JustBrenkman/sora/projects/pinion/hardware/pinion-main/README.md

# pinion-main

Main board: TI AM62L and STM32H743 flight controller on one PCB.

Create the KiCad project here as `pinion-main.kicad_pro`.

[SCHEMATIC_TODO.md](SCHEMATIC_TODO.md) lists every part to place and the nets it
connects to. Net labels come from the pin maps in `../../specs/pinout/`.
