JustBrenkman/sora/projects/pinion/specs/notes/am62l-io-domains.md

<!-- SPDX-License-Identifier: CC-BY-4.0 -->
# AM62L I/O supply groups

Generated by `specs/tools/gen_am62l_pindef.py` from Table 5-1 of the AM62L
datasheet. pinmap has no field for a ball's I/O supply, so it is kept here.
A pin's I/O voltage is the voltage of the supply rail listed for its group.

## VDDA_1P8_DSI (1.8V)

| Ball | Pin | PADCONFIG |
|---|---|---|
| A15 | DSI0_TXCLKN |  |
| A14 | DSI0_TXCLKP |  |
| B19 | DSI0_TXN0 |  |
| A18 | DSI0_TXN1 |  |
| A20 | DSI0_TXN2 |  |
| B22 | DSI0_TXN3 |  |
| B18 | DSI0_TXP0 |  |
| A17 | DSI0_TXP1 |  |
| A21 | DSI0_TXP2 |  |
| B21 | DSI0_TXP3 |  |
| D17 | DSI0_TXRCALIB |  |

## VDDA_ADC (1.8V)

| Ball | Pin | PADCONFIG |
|---|---|---|
| V20 | ADC0_AIN0 |  |
| V22 | ADC0_AIN1 |  |
| V23 | ADC0_AIN2 |  |
| V21 | ADC0_AIN3 |  |

## VDDS0 (1.8V)

| Ball | Pin | PADCONFIG |
|---|---|---|
| Y16 | EMU0 | 0x04084034 |
| AA16 | EMU1 | 0x04084038 |
| AC15 | MDIO0_MDC | 0x0408414C |
| AC13 | MDIO0_MDIO | 0x04084148 |
| Y8 | RGMII1_RD0 | 0x04084138 |
| AA6 | RGMII1_RD1 | 0x0408413C |
| AA8 | RGMII1_RD2 | 0x04084140 |
| W8 | RGMII1_RD3 | 0x04084144 |
| Y7 | RGMII1_RXC | 0x04084134 |
| Y6 | RGMII1_RX_CTL | 0x04084130 |
| AC10 | RGMII1_TD0 | 0x04084120 |
| W13 | RGMII1_TD1 | 0x04084124 |
| Y11 | RGMII1_TD2 | 0x04084128 |
| AA11 | RGMII1_TD3 | 0x0408412C |
| W11 | RGMII1_TXC | 0x0408411C |
| AB11 | RGMII1_TX_CTL | 0x04084118 |
| AB9 | RGMII2_RD0 | 0x04084170 |
| AC9 | RGMII2_RD1 | 0x04084174 |
| AB10 | RGMII2_RD2 | 0x04084178 |
| AB8 | RGMII2_RD3 | 0x0408417C |
| AC7 | RGMII2_RXC | 0x0408416C |
| AC8 | RGMII2_RX_CTL | 0x04084168 |
| AC12 | RGMII2_TD0 | 0x04084158 |
| AB13 | RGMII2_TD1 | 0x0408415C |
| AA12 | RGMII2_TD2 | 0x04084160 |
| AA13 | RGMII2_TD3 | 0x04084164 |
| Y13 | RGMII2_TXC | 0x04084154 |
| AB12 | RGMII2_TX_CTL | 0x04084150 |
| AB14 | TCK | 0x04084020 |
| AC16 | TDI | 0x04084028 |
| AB15 | TDO | 0x0408402C |
| Y17 | TMS | 0x04084030 |
| AB16 | TRSTn | 0x04084024 |

## VDDS1 (1.8V)

| Ball | Pin | PADCONFIG |
|---|---|---|
| D22 | OSPI0_CLK | 0x0408403C |
| C20 | OSPI0_CSn0 | 0x04084068 |
| D20 | OSPI0_CSn1 | 0x0408406C |
| D18 | OSPI0_CSn2 | 0x04084070 |
| C23 | OSPI0_CSn3 | 0x04084074 |
| C22 | OSPI0_D0 | 0x04084048 |
| D21 | OSPI0_D1 | 0x0408404C |
| E23 | OSPI0_D2 | 0x04084050 |
| D23 | OSPI0_D3 | 0x04084054 |
| F21 | OSPI0_D4 | 0x04084058 |
| F19 | OSPI0_D5 | 0x0408405C |
| G20 | OSPI0_D6 | 0x04084060 |
| F20 | OSPI0_D7 | 0x04084064 |
| E22 | OSPI0_DQS | 0x04084044 |
| E18 | OSPI0_LBCLKO | 0x04084040 |

## VDDSHV0 (1.8V / 3.3V)

| Ball | Pin | PADCONFIG |
|---|---|---|
| L22 | GPMC0_AD0 | 0x04084078 |
| L23 | GPMC0_AD1 | 0x0408407C |
| H21 | GPMC0_AD10 | 0x040840A0 |
| H18 | GPMC0_AD11 | 0x040840A4 |
| G23 | GPMC0_AD12 | 0x040840A8 |
| G22 | GPMC0_AD13 | 0x040840AC |
| F22 | GPMC0_AD14 | 0x040840B0 |
| F23 | GPMC0_AD15 | 0x040840B4 |
| K22 | GPMC0_AD2 | 0x04084080 |
| J23 | GPMC0_AD3 | 0x04084084 |
| K23 | GPMC0_AD4 | 0x04084088 |
| H22 | GPMC0_AD5 | 0x0408408C |
| H23 | GPMC0_AD6 | 0x04084090 |
| J22 | GPMC0_AD7 | 0x04084094 |
| H19 | GPMC0_AD8 | 0x04084098 |
| H20 | GPMC0_AD9 | 0x0408409C |
| N19 | GPMC0_ADVn_ALE | 0x040840C0 |
| P23 | GPMC0_BE0n_CLE | 0x040840CC |
| P22 | GPMC0_BE1n | 0x040840D0 |
| L21 | GPMC0_CLK | 0x040840B8 |
| L20 | GPMC0_CSn0 | 0x040840E4 |
| L19 | GPMC0_CSn1 | 0x040840E8 |
| M23 | GPMC0_CSn2 | 0x040840EC |
| M22 | GPMC0_CSn3 | 0x040840F0 |
| M21 | GPMC0_DIR | 0x040840E0 |
| N20 | GPMC0_OEn_REn | 0x040840C4 |
| N23 | GPMC0_WAIT0 | 0x040840D4 |
| N22 | GPMC0_WAIT1 | 0x040840D8 |
| M19 | GPMC0_WEn | 0x040840C8 |
| N21 | GPMC0_WPn | 0x040840DC |

## VDDSHV1 (1.8V / 3.3V)

| Ball | Pin | PADCONFIG |
|---|---|---|
| C8 | EXTINTn | 0x040841E8 |
| D16 | EXT_REFCLK1 | 0x040841E4 |
| B7 | I2C0_SCL | 0x040841CC |
| A7 | I2C0_SDA | 0x040841D0 |
| D7 | I2C1_SCL | 0x040841D4 |
| A6 | I2C1_SDA | 0x040841D8 |
| B8 | I2C2_SCL | 0x040841DC |
| D8 | I2C2_SDA | 0x040841E0 |
| B15 | MCAN0_RX | 0x040841C8 |
| B16 | MCAN0_TX | 0x040841C4 |
| A12 | MCASP0_ACLKR | 0x0408419C |
| A11 | MCASP0_ACLKX | 0x04084190 |
| C11 | MCASP0_AFSR | 0x04084198 |
| B11 | MCASP0_AFSX | 0x04084194 |
| B9 | MCASP0_AXR0 | 0x0408418C |
| A9 | MCASP0_AXR1 | 0x04084188 |
| B10 | MCASP0_AXR2 | 0x04084184 |
| A8 | MCASP0_AXR3 | 0x04084180 |
| B6 | MMC1_SDCD | 0x04084234 |
| D6 | MMC1_SDWP | 0x04084238 |
| C16 | RESETSTATz | 0x04084240 |
| E16 | RESETz | 0x0408423C |
| E13 | SPI0_CLK | 0x040841A8 |
| E11 | SPI0_CS0 | 0x040841A0 |
| D11 | SPI0_CS1 | 0x040841A4 |
| E12 | SPI0_D0 | 0x040841AC |
| B12 | SPI0_D1 | 0x040841B0 |
| B14 | UART0_CTSn | 0x040841BC |
| B13 | UART0_RTSn | 0x040841C0 |
| D13 | UART0_RXD | 0x040841B4 |
| C13 | UART0_TXD | 0x040841B8 |
| C6 | USB0_DRVVBUS | 0x04084244 |
| A5 | USB1_DRVVBUS | 0x04084248 |

## VDDSHV2 (1.8V / 3.3V)

| Ball | Pin | PADCONFIG |
|---|---|---|
| B2 | MMC0_CLK | 0x0408420C |
| D2 | MMC0_CMD | 0x04084214 |
| D3 | MMC0_DAT0 | 0x04084208 |
| D4 | MMC0_DAT1 | 0x04084204 |
| C1 | MMC0_DAT2 | 0x04084200 |
| C2 | MMC0_DAT3 | 0x040841FC |
| C4 | MMC0_DAT4 | 0x040841F8 |
| B3 | MMC0_DAT5 | 0x040841F4 |
| A3 | MMC0_DAT6 | 0x040841F0 |
| B4 | MMC0_DAT7 | 0x040841EC |

## VDDSHV3 (1.8V / 3.3V)

| Ball | Pin | PADCONFIG |
|---|---|---|
| Y2 | MMC1_CLK | 0x04084228 |
| Y3 | MMC1_CMD | 0x04084230 |
| AA1 | MMC1_DAT0 | 0x04084224 |
| Y4 | MMC1_DAT1 | 0x04084220 |
| AA2 | MMC1_DAT2 | 0x0408421C |
| AB2 | MMC1_DAT3 | 0x04084218 |

## VDDSHV4 (1.8V / 3.3V)

| Ball | Pin | PADCONFIG |
|---|---|---|
| R23 | MMC2_CLK | 0x04084104 |
| U23 | MMC2_CMD | 0x0408410C |
| U22 | MMC2_DAT0 | 0x04084100 |
| T22 | MMC2_DAT1 | 0x040840FC |
| T23 | MMC2_DAT2 | 0x040840F8 |
| R22 | MMC2_DAT3 | 0x040840F4 |
| T20 | MMC2_SDCD | 0x04084110 |
| T21 | MMC2_SDWP | 0x04084114 |

## VDDS_DDR (1.1V / 1.2V)

| Ball | Pin | PADCONFIG |
|---|---|---|
| L5 | DDR0_A0 |  |
| H6 | DDR0_A1 |  |
| T5 | DDR0_A10 |  |
| T6 | DDR0_A11 |  |
| W6 | DDR0_A12 |  |
| V6 | DDR0_A13 |  |
| L6 | DDR0_A2 |  |
| K2 | DDR0_A3 |  |
| J1 | DDR0_A4 |  |
| H5 | DDR0_A5 |  |
| R2 | DDR0_A6 |  |
| N6 | DDR0_A7 |  |
| T4 | DDR0_A8 |  |
| N1 | DDR0_A9 |  |
| M2 | DDR0_ACT_n |  |
| N3 | DDR0_BA0 |  |
| N2 | DDR0_BA1 |  |
| N5 | DDR0_BG0 |  |
| N4 | DDR0_BG1 |  |
| M3 | DDR0_CAL0 |  |
| L1 | DDR0_CAS_n |  |
| P1 | DDR0_CK0 |  |
| P2 | DDR0_CK0_n |  |
| K1 | DDR0_CKE0 |  |
| L3 | DDR0_CS0_n |  |
| F2 | DDR0_DM0 |  |
| W2 | DDR0_DM1 |  |
| F4 | DDR0_DQ0 |  |
| F3 | DDR0_DQ1 |  |
| T1 | DDR0_DQ10 |  |
| U1 | DDR0_DQ11 |  |
| U4 | DDR0_DQ12 |  |
| V5 | DDR0_DQ13 |  |
| U2 | DDR0_DQ14 |  |
| W1 | DDR0_DQ15 |  |
| F1 | DDR0_DQ2 |  |
| E1 | DDR0_DQ3 |  |
| G4 | DDR0_DQ4 |  |
| H4 | DDR0_DQ5 |  |
| H2 | DDR0_DQ6 |  |
| H3 | DDR0_DQ7 |  |
| V4 | DDR0_DQ8 |  |
| T3 | DDR0_DQ9 |  |
| G1 | DDR0_DQS0 |  |
| G2 | DDR0_DQS0_n |  |
| V1 | DDR0_DQS1 |  |
| V2 | DDR0_DQS1_n |  |
| L4 | DDR0_ODT0 |  |
| M5 | DDR0_RAS_n |  |
| J2 | DDR0_RESET0_n |  |
| L2 | DDR0_WE_n |  |

## VDDS_OSC0 (1.8V)

| Ball | Pin | PADCONFIG |
|---|---|---|
| AB18 | PORz | 0x0408401C |
| AC18 | WKUP_OSC0_XI |  |
| AC17 | WKUP_OSC0_XO |  |

## VDDS_RTC (1.8V)

| Ball | Pin | PADCONFIG |
|---|---|---|
| AB19 | EXT_WAKEUP0 |  |
| AB20 | EXT_WAKEUP1 |  |
| AC21 | LFOSC0_XI |  |
| AC20 | LFOSC0_XO |  |
| AA18 | PMIC_LPM_EN0 |  |
| Y18 | RTC_PORz |  |

## VDDS_WKUP (1.8V)

| Ball | Pin | PADCONFIG |
|---|---|---|
| Y23 | WKUP_CLKOUT0 | 0x04084018 |
| AB22 | WKUP_I2C0_SCL | 0x04084010 |
| AA22 | WKUP_I2C0_SDA | 0x04084014 |
| W23 | WKUP_UART0_CTSn | 0x04084008 |
| W22 | WKUP_UART0_RTSn | 0x0408400C |
| Y22 | WKUP_UART0_RXD | 0x04084000 |
| AA23 | WKUP_UART0_TXD | 0x04084004 |
