JustBrenkman/sora/projects/pinion/hardware/pinion-main/pinion-main.kicad_pcb

## KiCad design M304N.kicad_sch


Parts:
BT1: Battery_Cell
IC1: TEENSY_4.1; TEENSY41; Manufacturer_Part_Number TEENSY 4.1
J1: USB_A

Connections:
3.3V: IC1.42 (3.3V_1)
GND: BT1.2 (-), IC1.45 (GND_1), IC1.48 (GND_2), IC1.49 (GND_3), IC1.69 (GND_4), IC1.70 (GND_5), IC1.71 (GND_6), J1.4 (GND), J1.SH (Shield)
unnamed: BT1.1 (+), IC1.43 (VBAT)
unnamed: IC1.50 (D+), J1.3 (D+)
unnamed: IC1.51 (D-), J1.2 (D-)
unnamed: IC1.52 (+5V), J1.1 (VBUS)
SCL: IC1.19 (A5)
SDA: IC1.18 (A4)
