JustBrenkman/sora/projects/pinion/hardware/pinion-main/pinion-main.kicad_pcb

## KiCad design display_unit.kicad_sch


Parts:
LCD1: 20x4 5V
U2: AE-PCA9306

Connections:
3.3V: U2.1 (VREF1)
5V: LCD1.1 (5V), U2.8 (VREF2)
GND: LCD1.4 (GND), U2.5 (GND)
unnamed: LCD1.2 (SCL), U2.7 (SCL2)
unnamed: LCD1.3 (SDA), U2.6 (SDA2)
SCL: U2.2 (SCL1)
SDA: U2.3 (SDA1)
