JustBrenkman/sora/(commit log)

2026-10-03 pin mapping done
2026-10-03 revised pinouts, schematic todo and added 30.5 x 30.5 moutning holes
2026-10-03 [pinion] create kicad project for main board
    [pinion-main.kicad_pcb, pinion-main.kicad_sch]
2026-10-03 [pinion] created sub-sheets
    [ddr4.kicad_sch, ethernet.kicad_sch, fmu-connectors.kicad_sch, fmu-power.kicad_sch, fmu.kicad_sch, io-mcu.kicad_sch, linux.kicad_sch, mcu.kicad_sch]
2026-10-03 [pinion] added mcu, mpu and external library
    [io-mcu.kicad_sch, mcu.kicad_sch, pmic.kicad_sch, soc.kicad_sch]
2026-10-03 [pinion] added all the sensors
    [nvm.kicad_sch, sensors.kicad_sch, ucan.kicad_sch]
2026-10-03 [pinion] added 5v input power
    [pinion-main.kicad_sch, power.kicad_sch]
2026-10-04 [pinion] added 30.5x30.5 mounting holes
    [pinion-main.kicad_sch]
2026-10-04 [pinion] 3v3 power for sys and fmu
    [fmu-power.kicad_sch, pinion-main.kicad_sch, power.kicad_sch]
2026-10-04 [pinion] mcu basic schematic in
    [fmu-power.kicad_sch, fmu.kicad_sch, mcu.kicad_sch]
2026-10-04 [pinion] mcu sheey updated
    [mcu.kicad_sch]
2026-10-04 [pinion] fmu sensors, external heated sensor board
    [nvm.kicad_sch, pinion-imu.kicad_sch, sensors.kicad_sch]
2026-10-07 [pinion] fmu connectors and esd protection
    [fmu-connectors.kicad_sch, pinion-imu.kicad_sch, sensors.kicad_sch]
2026-10-08 [pinion] fmu can transievers
    [fmu.kicad_sch, ucan.kicad_sch]
